TechMind428/cw_decoder4-pico2/THIRD_PARTY_NOTICES.md

# Third-party notices

このプロジェクトは、下記のオープンソースソフトウェアを利用しています。
配布時は、実際にビルドした各バージョンの著作権表示と
ライセンス文をソースパッケージに含めてください。

## LovyanGFX

- Version: 1.2.26
- Project: <https://github.com/lovyan03/LovyanGFX>
- Main license: FreeBSD License (2-clause BSD family)
- Package metadata: `MIT AND BSD-2-Clause`

LovyanGFXには、MIT、BSD、IPA Font Licenseなどが適用される
フォントやサブコンポーネントが含まれます。正確な条件は、
[`LICENSES/LovyanGFX-license.txt`](LICENSES/LovyanGFX-license.txt)を参照してください。

## Arduino-Pico

- Package: Earle F. Philhower, III Arduino-Pico core
- Framework package used for the verified build: `1.50601.0+sha.832f2c06`
- Project: <https://github.com/earlephilhower/arduino-pico>
- Top-level license supplied by the package: GNU LGPL 2.1

Arduino-PicoにはPico SDKなどの複数のサブコンポーネントが含まれます。
トップレベルのLGPL 2.1本文は
[`LICENSES/Arduino-Pico-LGPL-2.1.txt`](LICENSES/Arduino-Pico-LGPL-2.1.txt)に収録しています。
配布時はArduino-Picoソースパッケージ内の`LICENSE`および
`docs/license.rst`に従ってください。

## Raspberry Pi RP2040 Platform for PlatformIO

- Source revision: `aa70b802be8851668053d4f09734e4089fe41932`
- Project: <https://github.com/maxgerhardt/platform-raspberrypi>
- Platform metadata license: Apache-2.0

## OZ1JHM CW Decoder

モールス復号ロジックは、Hjalmar Skovholm Hansen (OZ1JHM)氏の
CW Decoderを起源とします。

- Original project: <http://oz1jhm.dk/content/very-simpel-cw-decoder-easy-build>
- License URL stated by the original source: <https://www.gnu.org/copyleft/gpl.html>

参照できる元ソースには「GPL」とありますが、GPLのバージョン番号は
明記されていません。新リポジトリを公開する前に、権利者または上流プロジェクトに
適用バージョンを確認し、正式な`LICENSE`ファイルを追加する必要があります。
