TechMind428/cw_decoder4-pico2/hardware/case/TENSTAR_ROBOT_2.8_ST7789V_mechanical_reference_R12.dxf

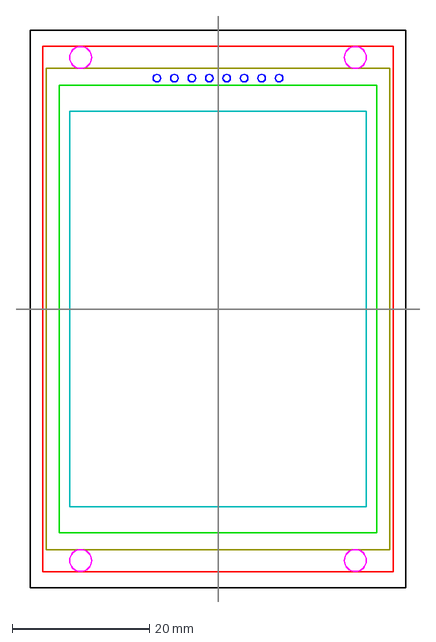
[picture p1: CAD file, 2026-10-13]
hardware/case/TENSTAR_ROBOT_2.8_ST7789V_mechanical_reference_R12.dxf
58.7 x 85.3 mm
