TechMind428/cw_decoder4-pico2/hardware/case/cw_decoder.3mf

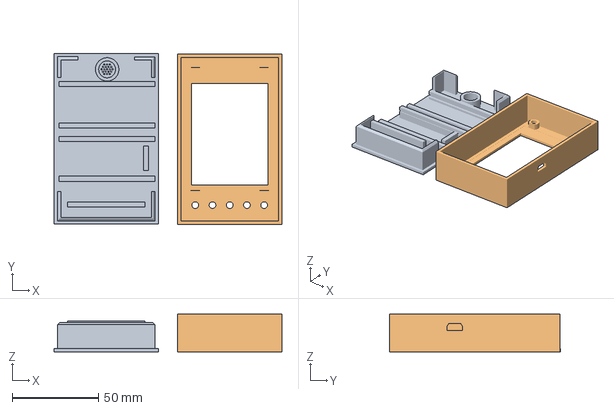
[picture p2: CAD file, 2026-10-13]
hardware/case/cw_decoder.3mf
132.5 x 99.6 x 22.0 mm
ボディ5.stl
ボディ1.stl
