TechMind428/cw_decoder4-pico2/hardware/wiring/CW_Decoder_for_Pico配線図.pdf

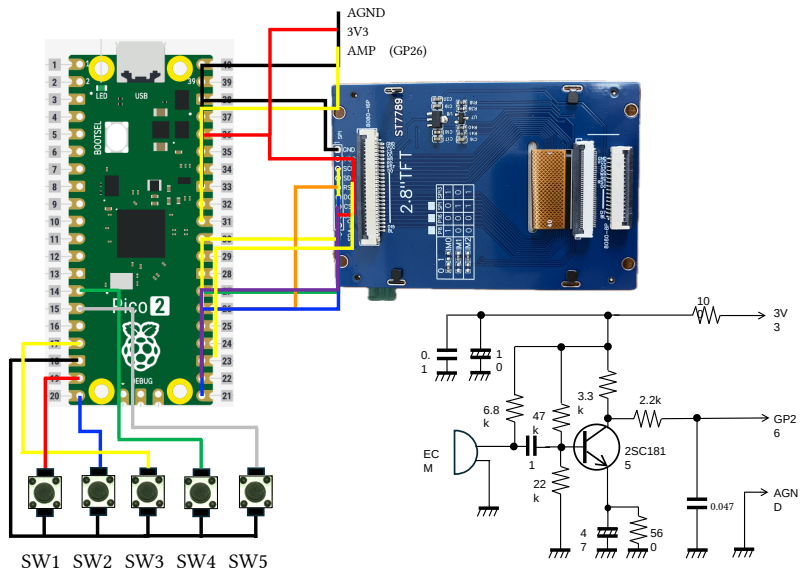
[picture p4: page 1]
AMP (GP26); AGN D; AGND 3V3

Pico | Pico GPIO
38 | GND | ST7789 GND | GND
36 | 3V3(OUT) | ST7789 VCC
24 | GP18 | ST7789 SCL | SPI SCK
25 | GP19 | ST7789 SDA | SPI MOSI
26 | GP20 | ST7789 RST | Reset
21 | GP16 | ST7789 DC | Data/Command
22 | GP17 | ST7789 CS | Chip Select
36 | 3V3(OUT) | ST7789 BL | Backlight
19 | GP14 | SW1
20 | GP15 | SW2 | US/JP
17 | GP13 | SW3
31 | GP26 / ADC0 | MIC/AF | ADC
33 | AGND | MIC/AF GND | GND
| GP25 | Pico LED | CW LED
16 | GP12 | | TEST
19 | GP14 | SW1 | US JP
20 | GP15 | SW2
17 | GP13 | SW3 | KEY
14 | GP10 | SW4 | ENV
15 | GP11 | SW5 | RAW
18 | GND | GND | SW GND
