TechMind428/cw_decoder4-pico2/src/dsp.h

//
//	DSP: 3ビンGoertzelトーン検出 (v1.9同等) + 表示用FFT/スコープデータ生成
//
#pragma once
#include <stdint.h>

#define DSP_SAMPLE_RATE 8000
// トーン判定のホップ (ブロック) 長。30 サンプル = 3.75ms。
// v2.0 のノイズ対策は ADC が実効 6.5kHz で動いていた状態で実機調整されており、
// そのときの物理条件 (窓 67Hz / サイド ±271Hz) を正しい 8kHz で再現しつつ、
// ホップは半分にしてある。なまりの量は窓長で決まりホップとは無関係なので、
// ホップを詰めるとギャップの底を細かく捉えられ、高速でも狭い窓を保てる
// (45WPM のギャップ 27ms に対し、窓 15ms を引いた底 12ms を 3 ブロックで拾える)。
// 副次的にデコーダの時間分解能も 3.75ms になり要素長の測定精度が上がる。
#define DSP_HOP 30
#define DSP_SPEC_N 256          // 表示用FFT (31.25Hz/bin)
#define DSP_SPEC_LOG2 8
#define DSP_SPEC_BINS 64        // 表示 0〜2kHz

typedef struct {
	int16_t mn;                 // 生波形 min (DC除去後)
	int16_t mx;                 // 生波形 max
	uint16_t mag;               // トーンエンベロープ (デコーダ正規化後)
	uint8_t gate;               // デコーダのキー判定 (0/1)
	uint32_t t_ms;              // 列生成時刻 (サンプル数由来 ms、ログの時間軸用)
	// トーン判定に使われた値 (スコープログでの原因調査用。列内最後のブロックの値)
	uint16_t side;              // 遠サイド (幾何平均、正規化後)
	uint16_t near;              // 近サイド (正規化後)
	uint16_t limit;             // 適応振幅しきい値 magnitudelimit
	uint16_t nf;                // ノイズ床推定 noise_floor
	uint16_t mag_min;           // 列内ブロックの最小マグニチュード
	uint8_t on_cnt;             // 列内で tone_on が成立したブロック数
	uint8_t off_cnt;            // 列内で tone_off が成立したブロック数
	uint8_t real_cnt;           // 列内で realstate が HIGH だったブロック数
	uint8_t hops;               // 列のブロック数 (上の分母)
} scope_col_t;

#define DSP_TONE_COUNT 5            // 600/700/800/900/1000Hz
#define DSP_TONE_AUTO DSP_TONE_COUNT // AUTO: 500〜1000Hzの最強ピークへ自動同調
// トーン判定Goertzel窓。長い方 120 = 15ms (帯域66.7Hz)、短い方 60 = 7.5ms (133Hz)。
// サイドビンはどちらの窓でも矩形窓のヌル上に乗る (長窓で±2/±4、短窓で±1/±2)
#define DSP_GATE_WIN_LONG 120
#define DSP_GATE_WIN_SHORT (DSP_GATE_WIN_LONG / 2)
#define DSP_GATE_WIN DSP_GATE_WIN_LONG      // バッファ確保用 (最大値)

void dsp_start(void);
// Core 1のloop1()から呼び、DSP_HOPサンプルの1ブロックを処理する。
void dsp_step(void);
// 上流とのAPI互換用。Pico 2版ではWi-Fi/OTAからは呼ばれない。
void dsp_set_paused(uint8_t paused);
void dsp_set_tone(uint8_t idx);     // 0..4=手動 / DSP_TONE_AUTO=自動
uint8_t dsp_tone_index(void);
uint8_t dsp_tone_is_auto(void);
uint16_t dsp_tone_hz(void);         // 現在のゲート中心周波数 (AUTO時は追従値)
uint16_t dsp_tone_hz_at(uint8_t idx);
// 直近 n カラム分を out[0]=最古 .. out[n-1]=最新 でコピー
int dsp_get_scope(scope_col_t *out, int n);
// これまでに生成したスコープ列の通し番号 (最新列 = 戻り値-1)。
// デコード文字をスコープの時間軸上に置くのに使う
uint32_t dsp_scope_col_index(void);
// 列番号 from_idx 以降の列を最大 max 個コピー (ログ用)。*first に先頭の列番号、
// *lost にリングから溢れて取れなかった列数。戻り値はコピーした列数
int dsp_get_scope_since(uint32_t from_idx, scope_col_t *out, int max,
                        uint32_t *first, uint32_t *lost);
uint16_t dsp_scope_period_q8(void);     // 現在の 1 列あたり hop 数 (Q8)
// デコード確定時に呼ぶ: その文字の符号区間 (最初のON列〜最後のOFF列) を返し、
// 次の文字の区間を開く。デコーダの emit コールバック内 (DSPタスク) から使う
void dsp_scope_char_span(uint32_t *start, uint32_t *end);
// スコープ1列の時間 (0.1ms単位)。掃引はWPM追従で可変
uint16_t dsp_scope_col_ms_x10(void);
// 現在のトーン判定帯域幅 (Hz)。窓長のWPM追従で約67/133が切り替わる
uint16_t dsp_gate_bw_hz(void);
// 入力レベル (ADCフルスケール比 0〜100%)。100%付近はクリップの目安
uint8_t dsp_input_level_pct(void);
// 入力ピーク振幅 (カウント、0〜2048 = ADC 半スイング、ピークホールド)。
// Pico ADCでは1カウント ≈ 0.806mV。dB表示用
int16_t dsp_input_peak(void);
// DSP_SPEC_BINS+1 個 (bin 0..64) をコピー
void dsp_get_spectrum(uint16_t *out);
uint16_t dsp_peak_hz(void);         // 検出ピーク周波数 (無信号時 0)
