TechMind428/cw_decoder4-pico2/src/audio.h

// Audio capture (Raspberry Pi Pico 2 ADC0 via chained DMA)
#pragma once
#include <stdint.h>
#include <stddef.h>

void audio_init(void);
// Reads up to DSP_HOP samples (blocking). Returns 12-bit values (0..4095).
size_t audio_read(uint16_t *dst, size_t n);
// ADCレール付近に達したサンプルの累積数（入力クリップ表示用）。
uint32_t audio_clip_total(void);
