TechMind428/cw_decoder4-pico2/(commit log)

2026-10-13 Port firmware to Raspberry Pi Pico 2
2026-10-13 Document Pico 2 build and third-party licenses
2026-10-13 Add wiring and enclosure design files
    [TENSTAR_ROBOT_2.8_ST7789V_mechanical_reference_R12.dxf, TENSTAR_ROBOT_2.8_ST7789V_mechanical_reference_R12_v2.dxf, cw_decoder.3mf]
2026-10-13 Port upstream v3.2 decoder to Raspberry Pi Pico 2
    [TENSTAR_ROBOT_2.8_ST7789V_mechanical_reference_R12.dxf, TENSTAR_ROBOT_2.8_ST7789V_mechanical_reference_R12_v2.dxf, cw_decoder.3mf]
2026-10-13 Document differences from the ESP32 version
2026-10-13 Publish wiring diagram as PDF
2026-10-13 Replace wiring PDF with public version
2026-10-13 Clarify Pico 2 wireless feature status
